Helfezer/DDD/Document/resume_semaine_18_11.docx

Lorsqu’une notification est envoyer (notificationgive) par une tache celle-ci ce met en attente, le

Utilisation de la boucle d’attente pour gérer le(s) bouton(s). Celui-ci permet le changement d’une variable globale (FINI) pour déterminer si le programme tourne ou non.
