Helfezer/DDD/Document/Tab_des_Pin.ods

Nordic | Resistance Pull up | SD Card | Switch Num SDA | Switch Num SCL | GY-88 1 | ADC
GND | - | GND | P6 | P6 | GND | P2
GND | - | - | P7 | P7 | G_AD0 | P5
GND | - | - | P8 | P8 | - | -
VCC/3,3V | - | VCC | - | - | - | P6
VCC/3,3V | - | - | - | - | - | P9
VCC/3,3V | - | - | - | - | - | P10
5V | - | - | P16 | P16 | VIN | -
P0.27 | vers le 3,3V | - | - | P3 | - | P8
P0.26 | vers le 3,3V | - | P3 | - | - | P7
P0.25 | - | SCK | - | - | - | -
P0.24 | - | D0 | - | - | - | -
P0.23 | - | D1 | - | - | - | -
P0.22 | - | CS | - | - | - | -
P0,30 | - | - | P9 | P9 | - | -
P0,29 | - | - | P10 | P10 | - | -
P0,28 | - | - | P11 | P11 | - | -
 | - | - | P13 | - | SDA | -
- | - | - | - | P13 | SCL | -
