Helfezer/DDD/attache_IMU.SLDPRT

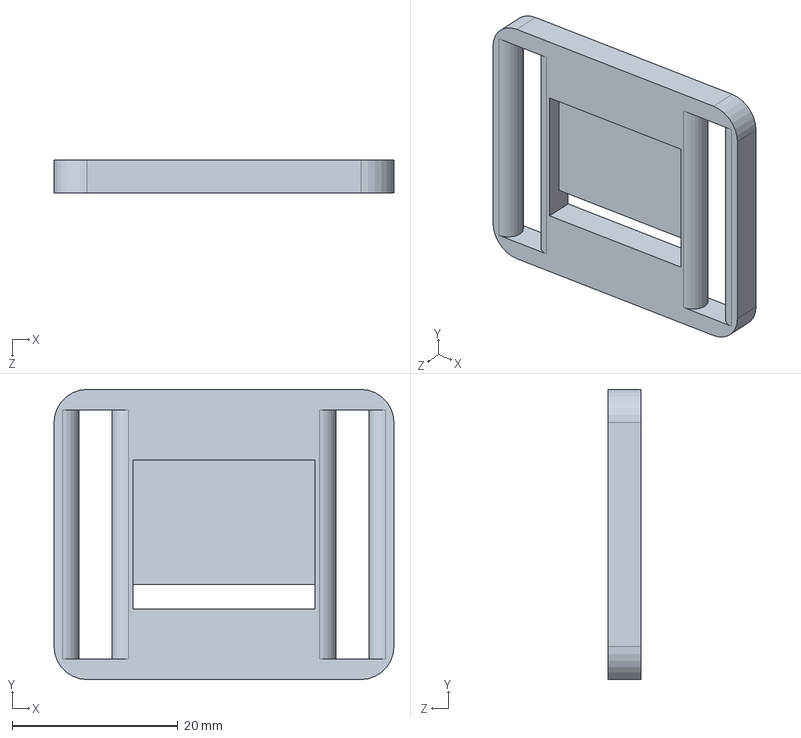
[picture p21: CAD file, 2018-02-05]
attache_IMU.SLDPRT
41.0 x 35.0 x 4.00 mm
