Helfezer/DDD/Eagle/Shield_schematic_MMS.brd

## EAGLE design Eagle/Shield_schematic_MMS.brd (2018-02-05)

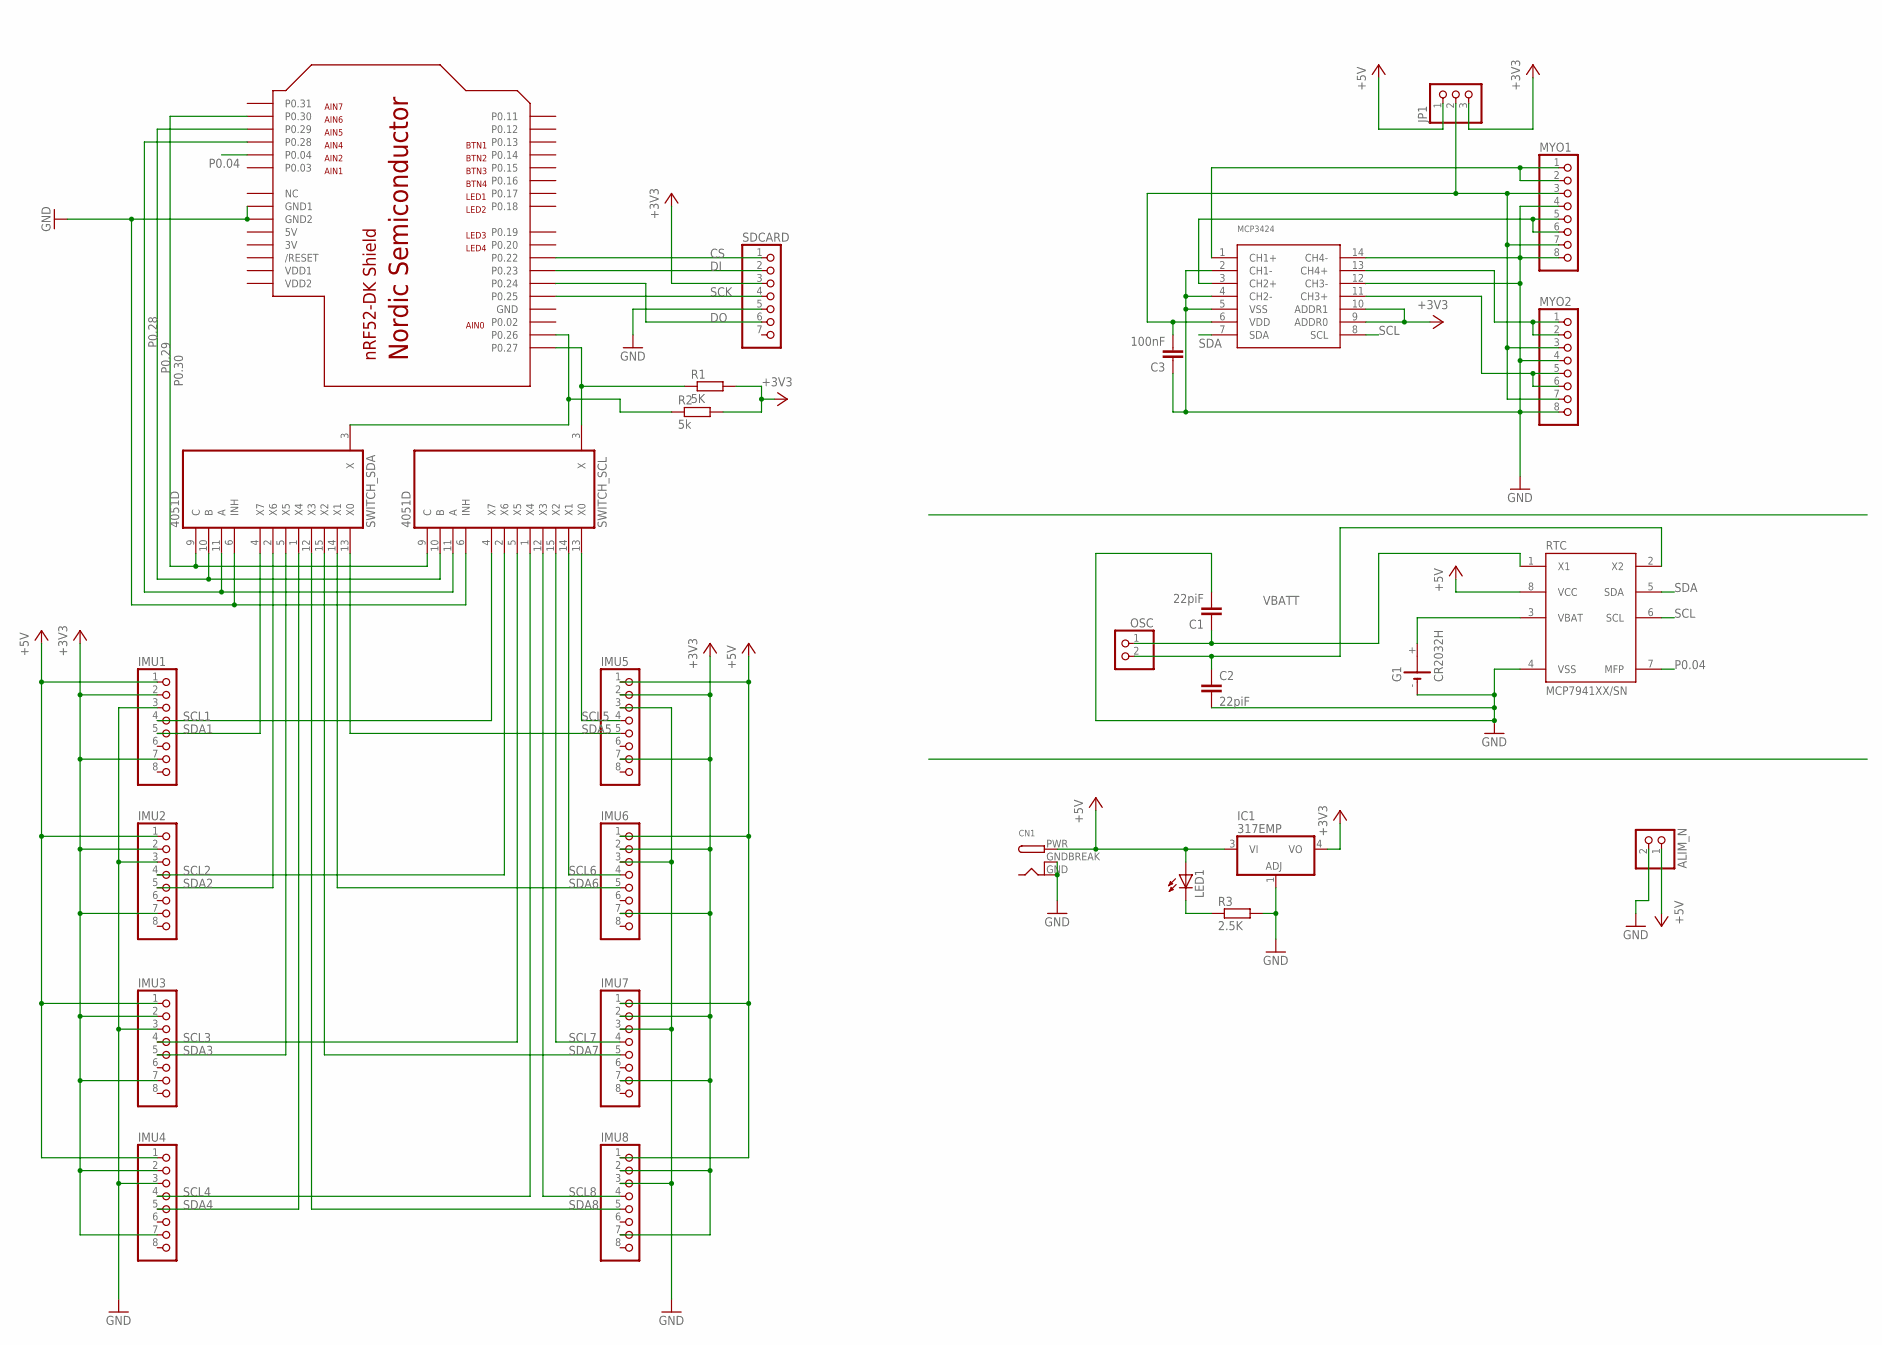
[picture p22: schematic Shield_schematic_MMS.sch]

Parts:
ALIM_N: PINHD-1X2; 1X02
C1, C2: 22piF; C2.5-2
C3: 100nF; C2.5-2
CN1: DCBARRELPTH; DCJACK_2MM_PTH
G1: CR2032H
IC1: 317EMP; SOT223
IMU1, IMU2, IMU3, IMU4, IMU5, IMU6, IMU7, IMU8: PINHD-1X8; 1X08
JP1: PINHD-1X3; 1X03
LED1: LEDCHIPLED_1206; CHIPLED_1206
MYO1, MYO2: PINHD-1X8; 1X08
OSC: PINHD-1X2; 1X02
R1: 5K; M1206
R2: 5k; M1206
R3: 2.5K; M1206
RTC: MCP7941XX/SN; SO8
SDCARD: PINHD-1X7; 1X07
SWITCH_SCL: 4051D; SO16
SWITCH_SDA: 4051D; SO16
U$2: NRF52-SHIELD-NOTEXT; NRF52-SHIELD
U$3: MCP3424; SO14

Connections:
3V: U$2.3V
5V: U$2.5V
+3V3: IC1.4 (VO), IMU1.2, IMU1.7, IMU2.2, IMU2.7, IMU3.2, IMU3.7, IMU4.2, IMU4.7, IMU5.2, IMU5.7, IMU6.2, IMU6.7, IMU7.2, IMU7.7, IMU8.2, IMU8.7, JP1.3, R1.2, R2.2, SDCARD.3, U$3.9 (ADDR0), U$3.10 (ADDR1)
+5V: ALIM_N.1, CN1.PWR, IC1.3 (VI), IMU1.1, IMU2.1, IMU3.1, IMU4.1, IMU5.1, IMU6.1, IMU7.1, IMU8.1, JP1.1, LED1.A, RTC.8 (VCC)
CH1: MYO1.1, MYO1.2, U$3.1 (CH1+)
CH2: MYO1.5, MYO1.6, U$3.3 (CH2+)
CH3: MYO2.5, MYO2.6, U$3.11 (CH3+)
CH4: MYO2.1, MYO2.2, U$3.13 (CH4+)
CS: SDCARD.1, U$2.P22 (P0.22)
DI: SDCARD.2, U$2.P23 (P0.23)
DO: SDCARD.6, U$2.P24 (P0.24)
GND: ALIM_N.2, C1.2, C2.2, C3.1, CN1.GND, CN1.GNDBREAK, G1.-, IC1.1 (ADJ), IMU1.3, IMU2.3, IMU3.3, IMU4.3, IMU5.3, IMU6.3, IMU7.3, IMU8.3, MYO1.4, MYO1.8, MYO2.4, MYO2.8, R3.2, RTC.4 (VSS), SDCARD.5, SWITCH_SCL.6 (INH), SWITCH_SCL.8 (GND), SWITCH_SDA.6 (INH), SWITCH_SDA.8 (GND), U$2.GND, U$2.GND1, U$2.GND2, U$3.2 (CH1-), U$3.4 (CH2-), U$3.5 (VSS), U$3.12 (CH3-), U$3.14 (CH4-)
unnamed: LED1.C, R3.1
P0.04: RTC.7 (MFP), U$2.P04 (P0.04)
P0.28: SWITCH_SCL.11 (A), SWITCH_SDA.11 (A), U$2.P28 (P0.28)
P0.29: SWITCH_SCL.10 (B), SWITCH_SDA.10 (B), U$2.P29 (P0.29)
P0.30: SWITCH_SCL.9 (C), SWITCH_SDA.9 (C), U$2.P30 (P0.30)
SCK: SDCARD.4, U$2.P25 (P0.25)
SCL: R1.1, RTC.6 (SCL), SWITCH_SCL.3 (X), U$2.P27 (P0.27), U$3.8 (SCL)
SCL1: IMU1.4, SWITCH_SCL.4 (X7)
SCL2: IMU2.4, SWITCH_SCL.2 (X6)
SCL3: IMU3.4, SWITCH_SCL.5 (X5)
SCL4: IMU4.4, SWITCH_SCL.1 (X4)
SCL5: IMU5.4, SWITCH_SCL.13 (X0)
SCL6: IMU6.4, SWITCH_SCL.14 (X1)
SCL7: IMU7.4, SWITCH_SCL.15 (X2)
SCL8: IMU8.4, SWITCH_SCL.12 (X3)
SDA: R2.1, RTC.5 (SDA), SWITCH_SDA.3 (X), U$2.P26 (P0.26), U$3.7 (SDA)
SDA1: IMU1.5, SWITCH_SDA.4 (X7)
SDA2: IMU2.5, SWITCH_SDA.2 (X6)
SDA3: IMU3.5, SWITCH_SDA.5 (X5)
SDA4: IMU4.5, SWITCH_SDA.1 (X4)
SDA5: IMU5.5, SWITCH_SDA.13 (X0)
SDA6: IMU6.5, SWITCH_SDA.14 (X1)
SDA7: IMU7.5, SWITCH_SDA.15 (X2)
SDA8: IMU8.5, SWITCH_SDA.12 (X3)
VBATT: G1.+, RTC.3 (VBAT)
VCC: SWITCH_SCL.16 (VCC), SWITCH_SDA.16 (VCC)
VDD: C3.2, JP1.2, MYO1.3, MYO1.7, MYO2.3, MYO2.7, U$3.6 (VDD)
VDD1: U$2.VDD2 (VDD1)
VDD2: U$2.VDD1 (VDD2)
VEE: SWITCH_SCL.7 (VEE), SWITCH_SDA.7 (VEE)
X1: C1.1, OSC.1, RTC.1 (X1)
X2: C2.1, OSC.2, RTC.2 (X2)

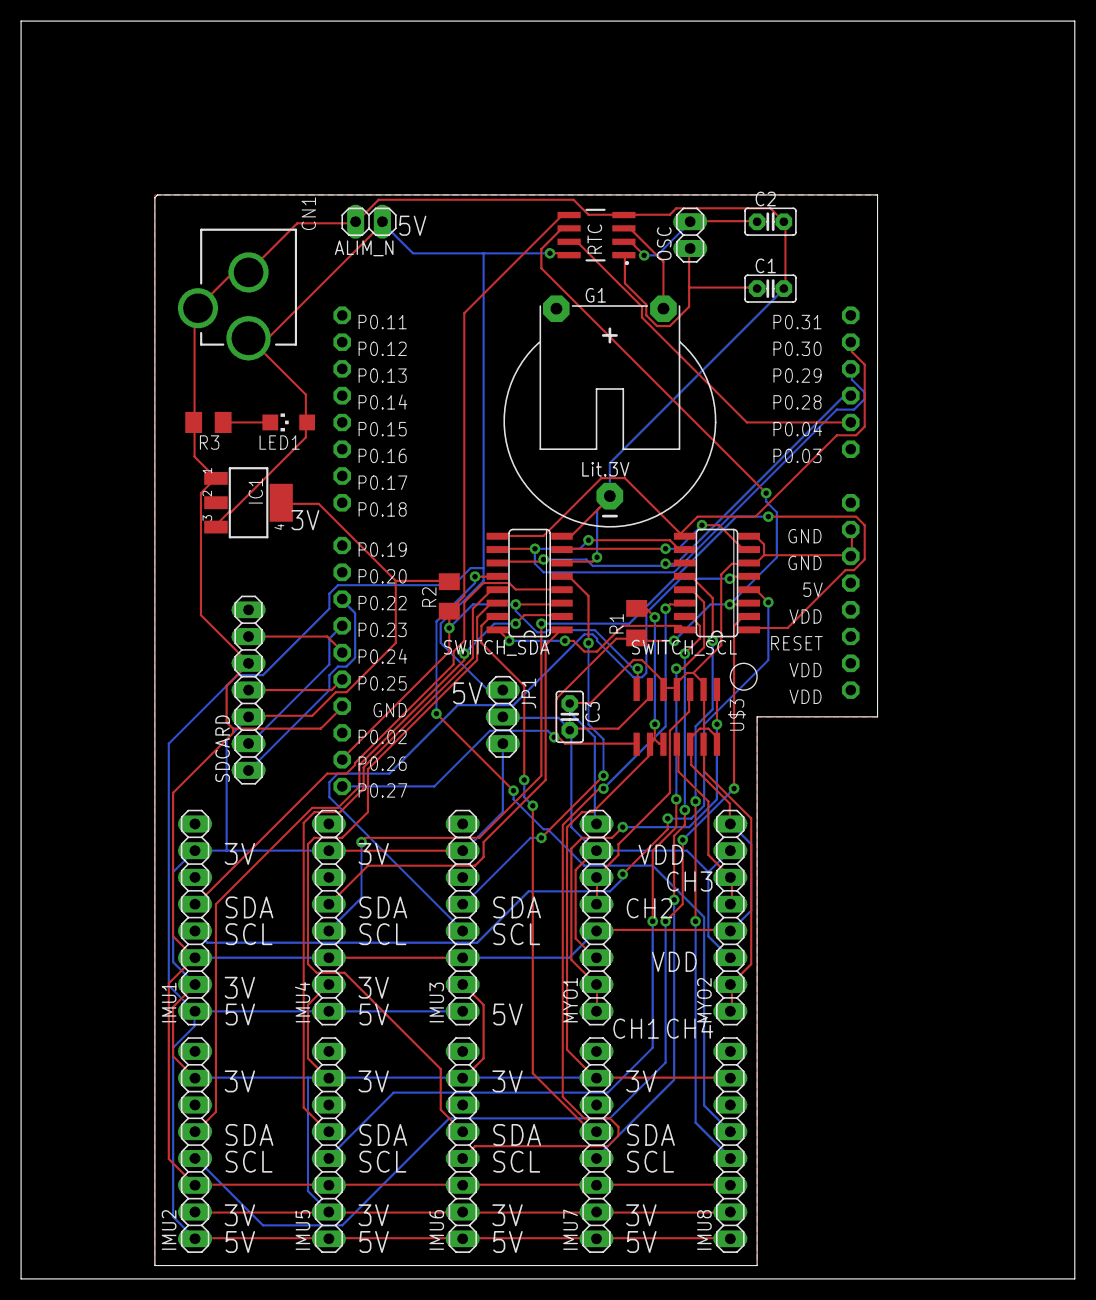
[picture p23: board Shield_schematic_MMS.brd from above]

Board: 2 copper layers, 100.0 x 119.4 mm, 29 parts (0 on the bottom side), 40 nets.
