Helfezer/DDD/salve_test/Patient0/README.txt

Bras droit, 1 IMU
1eré ligne + 1ere_serie = mouvement de l'avant bras, balayage dans le plan sagittal avec coude fixe
2eme ligne + 2eme_serie = mouvemeent de l'avant bras, mouvement de scie dans le plan sagital avec coude fixe
3eme ligne + 3eme_série = mouvement de l'avant bras, balayage dans le plan transversal avec coude fixe
