Helfezer/DDD/(commit log)

2017-10-09 Schéma Montage I2C + MPU6050
2017-10-09 Cahier des charges
2017-10-12 Code Initial: exemple LM75B modifié, reception/envoi i2c
2017-11-06 Schema eagle
    [Shield_schematic.brd, Shield_schematic.sch]
2017-11-06 Résumé de la semaine du 16/10/2017
2017-11-08 Modif schematic (ajout 2éme switch)
    [Shield_schematic.brd, Shield_schematic.sch]
2017-11-21 add datasheet ADC
2017-11-21 Add eagle directory + schema SD card
    [Shield_schematic.brd, Shield_schematic.sch]
2017-12-07 Datasheet mcp3424 + lib eagle + doc plan rapport
    [Shield_schematic.brd, Shield_schematic.sch]
2017-12-07 add mcp3424 sch in eagle
    [Shield_schematic.brd, Shield_schematic.sch]
2018-01-14 ajout datasheet + annexe/ maj sch
    [Shield_schematic.brd, Shield_schematic.sch, Tab_des_Pin.ods]
2018-01-26 Piéce SW + board finaliser
    [Shield_schematic.brd, Shield_schematic.sch, Shield_schematic_MMS.brd, Shield_schematic_MMS.sch, attache_IMU.SLDPRT]
2018-02-05 Derniére version Eagle
    [Shield_schematic_MMS.brd, Shield_schematic_MMS.sch, attache_IMU.SLDPRT]
2018-02-07 Add: resumé semaine 13/10/2017 et descriptif des premiers tests
2018-02-07 MàJ premiere campagne de mesure
2018-03-16 Ajout 1ére salve de mesure + modif python
